Dante-B-777/FPV-2026/Report/figures/fig_alloc.pdf

1. slide the
collective
2. scale
roll+pitch
3. fit yaw in
what is left

umin
250 rad/s

hover
975 rad/s

umax
1600 rad/s

## rotor u = ω2

requested | roll/pitch spread

yaw

collective
