Dante-B-777/FPV-2026/Report/figures/fig_body.pdf

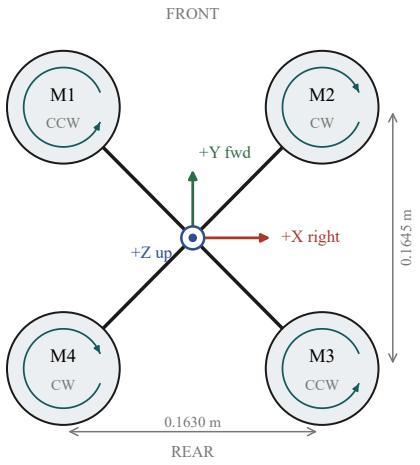
[picture p1: figure]
+X right; +Y fwd; FRONT; REAR; CCW

(a)
(b)
axis | M1 | M2 | M3 | M4 | produced by
Thrust T | | | | | kF Σui
Pitch τx | | | | | kFay(u1+u2−u3−u4)
Roll τy | | | | | kFax(u1−u2−u3+u4)
Yaw τz | | | | | −kM(u1−u2+u3−u4)

Filled = that rotor speeds up. ui = ω²
i

; ax = 0.0815 m, ay = 0.08225 m. A CCW rotor is driven against aerodynamic drag, so the airframe receives the opposite reaction. Yaw is therefore the only row set by kM instead of
kF, and kM/kF ≈ 0.01 m -- an eightfold authority deficit.

Sensor lever arms on the +Y centreline: PMW3901 at +0.040 m, VL53L0X at +0.070 m from the airframe centre.

+ | + | + | +
+ | + | − | −
+ | − | − | +
− | + | − | +
