Dante-B-777/FPV-2026/Report/figures/fig_states.pdf

(a) flight state machine

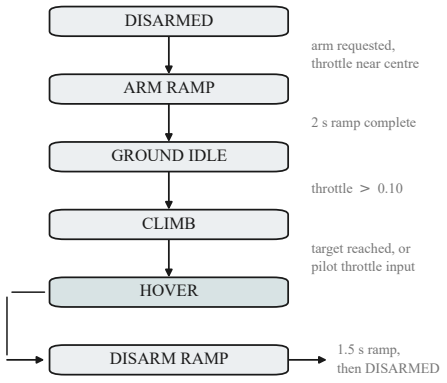
[picture p2: figure]
DISARMED; ARM RAMP; GROUND IDLE; CLIMB; HOVER; arm requested, throttle near centre; 2 s ramp complete; throttle > 0.10; target reached, or pilot throttle input; DISARM RAMP; 1.5 s ramp,; then DISARMED

released by: signal lost ⋅ kill ⋅ safety stop ⋅ serial stop ⋅ switch off

(b) per-axis hold engagement

stick input, or any precondition lost

capture requires the axis speed to stay below its threshold for the whole dwell, so the target is a point the vehicle is actually at:

altitude | 0.12 m/s | 400 ms
position | 0.15 m/s | 500 ms
heading | 8 deg/s | 300 ms

Position hold additionally requires proof, within this flight, that the yaw loop is behaving: rate within 10 deg/s and heading error within 8 deg, continuously for 3 s while airborne. Disarming clears the proof.
