Dante-B-777/FPV-2026/Report/preview/fig_alloc.png

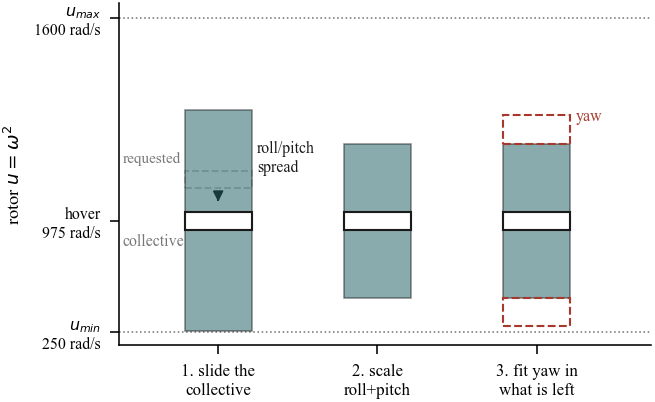
Report/preview/fig_alloc.png
