Dante-B-777/FPV-2026/Report/preview/fig_estimator.png

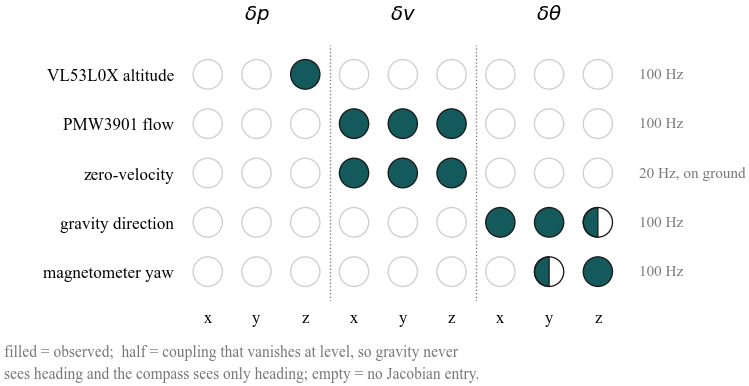
Report/preview/fig_estimator.png
