Dante-B-777/FPV-2026/Report/preview/fig_hover.png

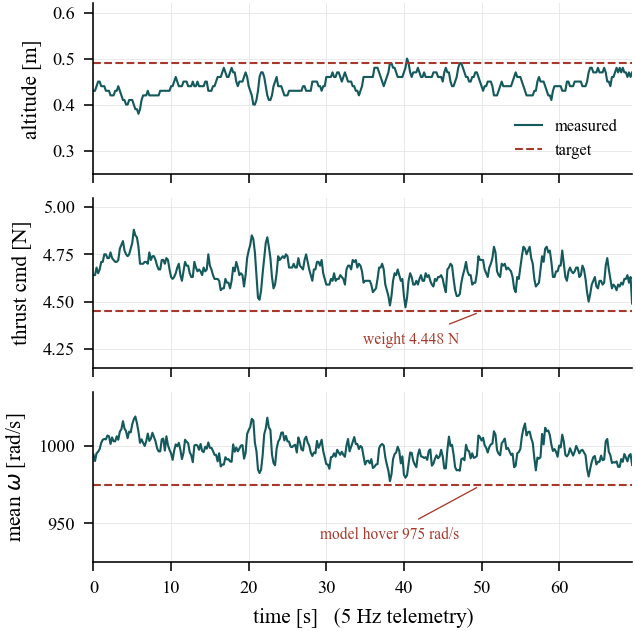
Report/preview/fig_hover.png
