Dante-B-777/FPV-2026/Schematics/wiring_transmitter.pdf

# FPV 2026 - TRANSMITTER

ESP32-WROOM-32 devkit | pins per Transmitter_RotorRate.ino | ESP-NOW peer 5C:01:3B:BA:CA:EC

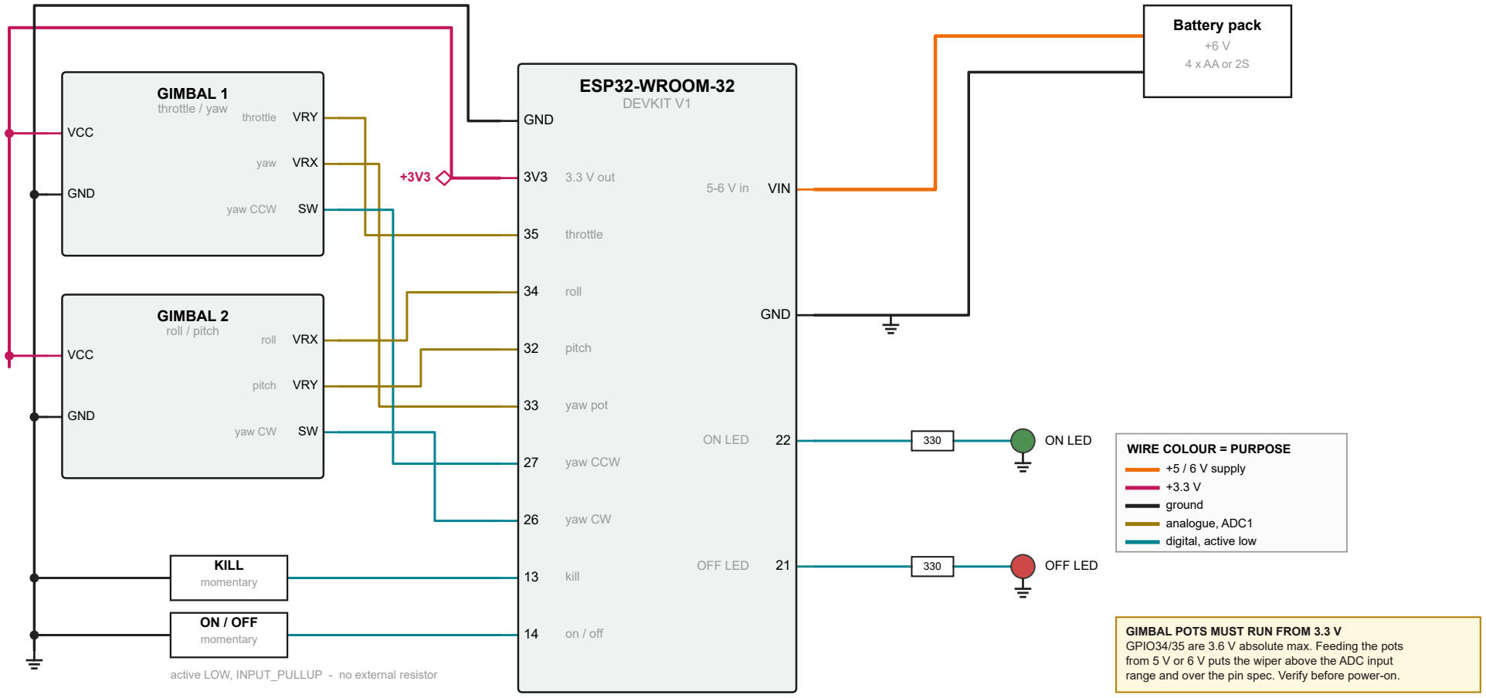
[picture p9: figure]
ESP32-WROOM-32 DEVKIT V1; GND; 3V3 3.3 V out; throttle; roll; pitch; yaw pot; yaw CCW; yaw CW; kill; on / off; VIN; ON LED; OFF LED; Battery pack; GIMBAL 1 throttle / yaw; VCC; VRY; yaw; VRX; GIMBAL 2 roll / pitch; KILL momentary; ON / OFF momentary; WIRE COLOUR = PURPOSE +5 / 6 V supply +3.3 V ground analogue, ADC1 digital, active low; GIMBAL POTS MUST RUN FROM 3.3 V

active LOW, INPUT_PULLUP - no external resistor

GPIO34/35 are 3.6 V absolute max. Feeding the pots from 5 V or 6 V puts the wiper above the ADC input range and over the pin spec. Verify before power-on.

NOTES
- All four axes use ADC1. ADC2 (0,2,4,12-15,25-27) cannot be read
while WiFi is up, and ESP-NOW keeps it up.
- GPIO33 yaw pot NOT FITTED: firmware default YAW_MODE 0 takes yaw from the two gimbal pushbuttons at +/-45 deg/s.
- GPIO34/35 are input-only; INPUT_PULLUP is unavailable there.
- Stick calibration lives in NVS, not in source.

SHEET

2 of 2 - transmitter

SOURCE

Transmitter_RotorRate.ino

LINK

ESP-NOW, 50 Hz
