Dante-B-777/FPV-2026/Schematics/wiring_transmitter.png

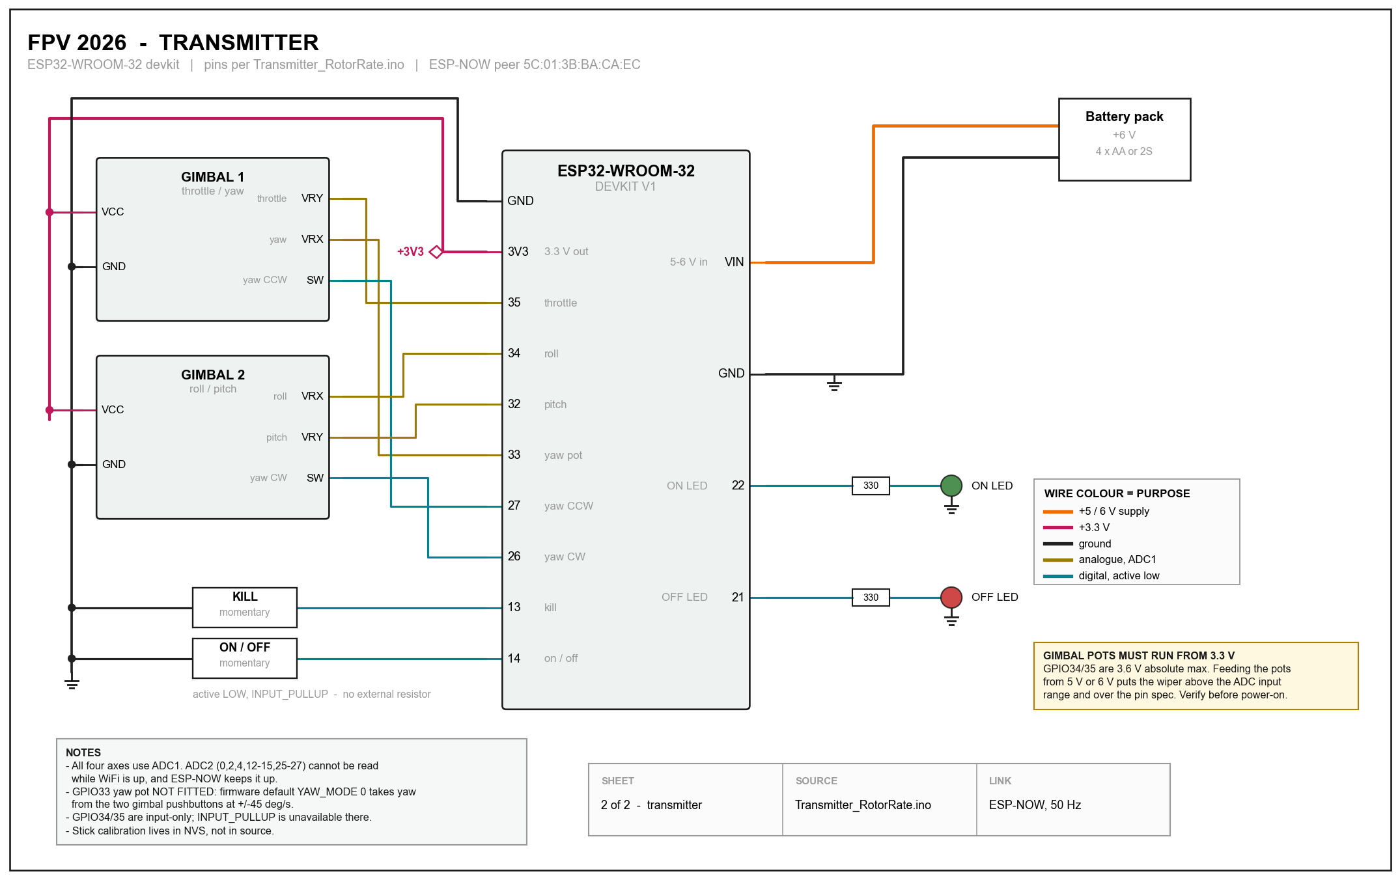
Schematics/wiring_transmitter.png
