Dante-B-777/FPV-2026/Schematics/wiring_receiver.pdf

# FPV 2026 - RECEIVER / FLIGHT CONTROLLER

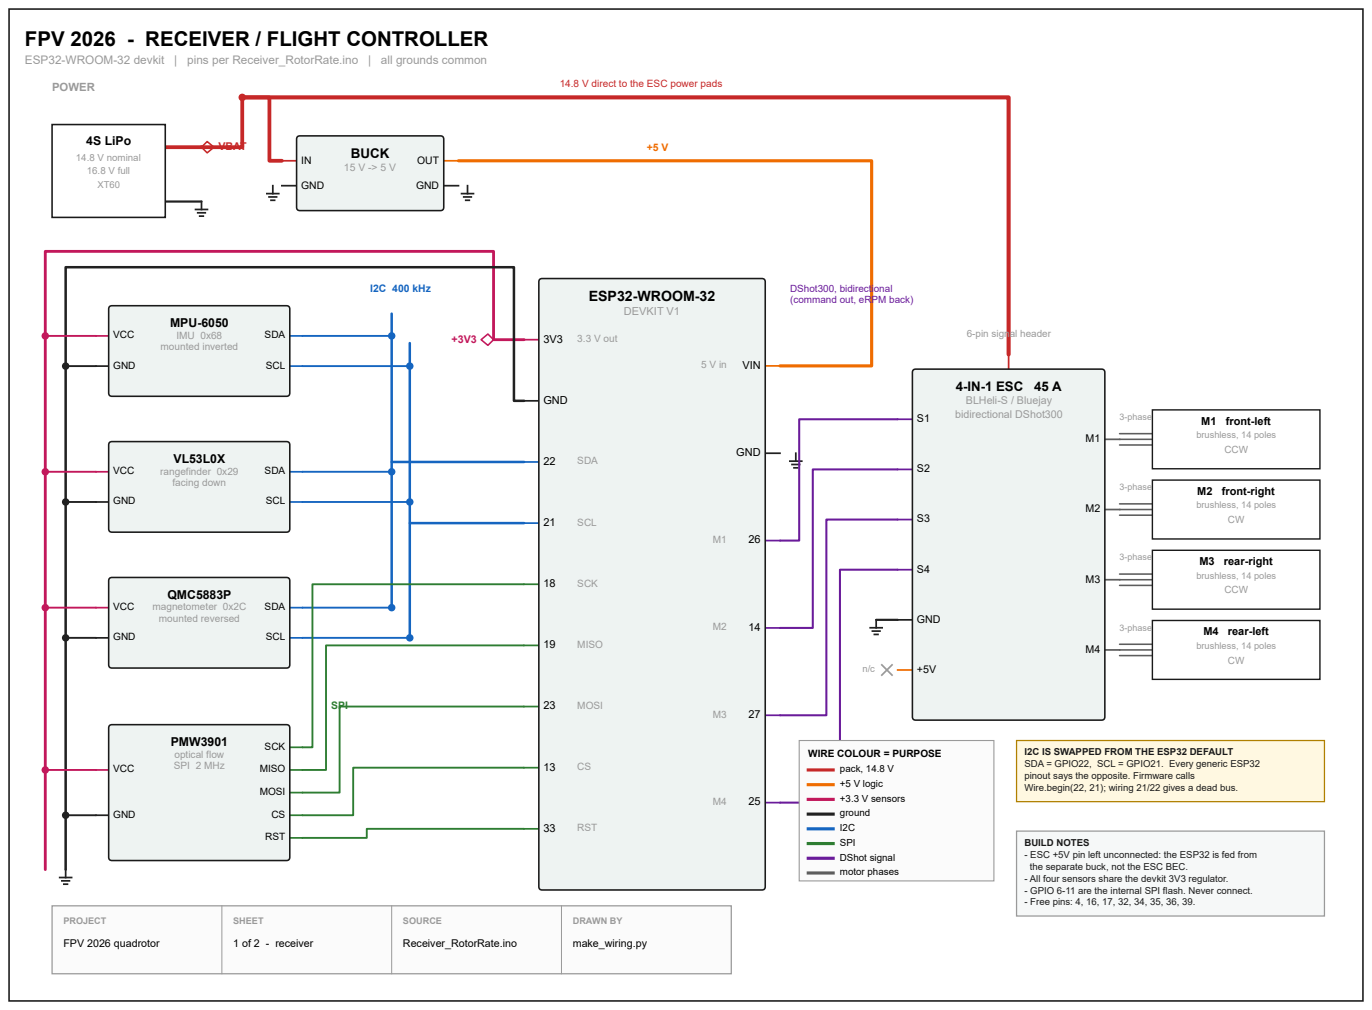
[picture p12: page 1]
POWER; I2C 400 kHz; SPI; 3-phase; 4S LiPo; 14.8 V nominal 16.8 V full XT60; VBAT; BUCK; GND; OUT; ESP32-WROOM-32 DEVKIT V1; 3V3 3.3 V out; SDA; SCL; SCK; MISO; MOSI; RST; VIN; MPU-6050 IMU 0x68 mounted inverted; VCC; VL53L0X rangefinder 0x29 facing down; QMC5883P magnetometer 0x2C mounted reversed; PMW3901 optical flow; 4-IN-1 ESC 45 A BLHeli-S / Bluejay bidirectional DShot300 S1; M1 front-left brushless, 14 poles CCW; M2 front-right brushless, 14 poles CW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

ESP32-WROOM-32 devkit | pins per Receiver_RotorRate.ino | all grounds common

14.8 V direct to the ESC power pads

DShot300, bidirectional
(command out, eRPM back)

6-pin signal header

I2C IS SWAPPED FROM THE ESP32 DEFAULT
SDA = GPIO22, SCL = GPIO21. Every generic ESP32
pinout says the opposite. Firmware calls
Wire.begin(22, 21); wiring 21/22 gives a dead bus.

SPI 2 MHz VCC

BUILD NOTES
- ESC +5V pin left unconnected: the ESP32 is fed from
the separate buck, not the ESC BEC.
- All four sensors share the devkit 3V3 regulator.
- GPIO 6-11 are the internal SPI flash. Never connect.
- Free pins: 4, 16, 17, 32, 34, 35, 36, 39.
