Dante-B-777/FPV-2026/Report/figures/fig_cascade.pdf

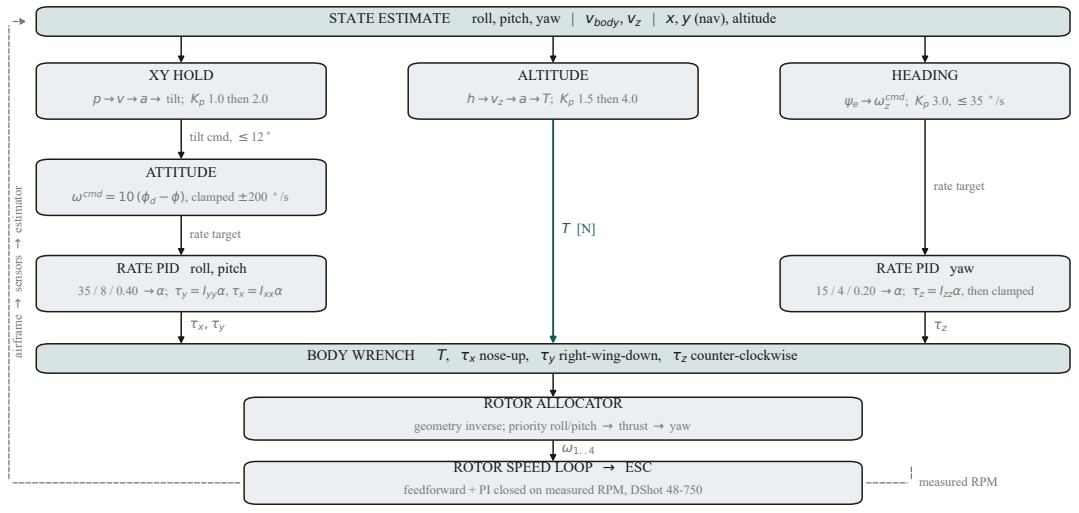
[picture p13: page 1]
STATE ESTIMATE; roll, pitch, yaw | vbody, vz | x, y (nav), altitude; XY HOLD; ALTITUDE; HEADING; ψe → ωcmd z; ATTITUDE; BODY WRENCH; T, τx nose-up, τy right-wing-down, τz counter-clockwise; ROTOR ALLOCATOR; feedforward + PI closed on measured RPM, DShot 48-750; measured RPM; tilt cmd, ≤ 12; rate target

p → v → a → tilt; Kp 1.0 then 2.0

h → vz → a → T; Kp 1.5 then 4.0

airframe → sensors → estimator

ωcmd = 10 (ϕd − ϕ), clamped ±200

RATE PID roll, pitch
35 / 8 / 0.40 → α; τy = Iyyα, τx = Ixxα

RATE PID yaw

15 / 4 / 0.20 → α; τz = Izzα, then clamped

geometry inverse; priority roll/pitch → thrust → yaw

ROTOR SPEED LOOP → ESC
