Dante-B-777/FPV-2026/Report/figures/fig_estimator.pdf

δp | δv | δθ

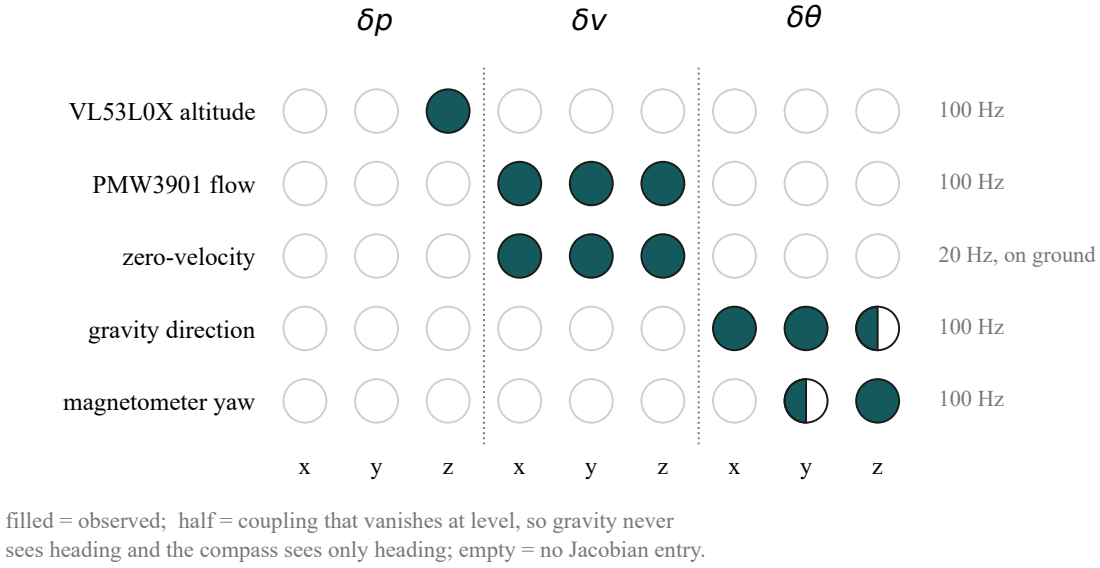
[picture p14: page 1]
VL53L0X altitude; PMW3901 flow; zero-velocity; gravity direction; magnetometer yaw

20 Hz, on ground

filled = observed; half = coupling that vanishes at level, so gravity never
sees heading and the compass sees only heading; empty = no Jacobian entry.
