Dante-B-777/FPV-2026/Report/figures/fig_hover.pdf

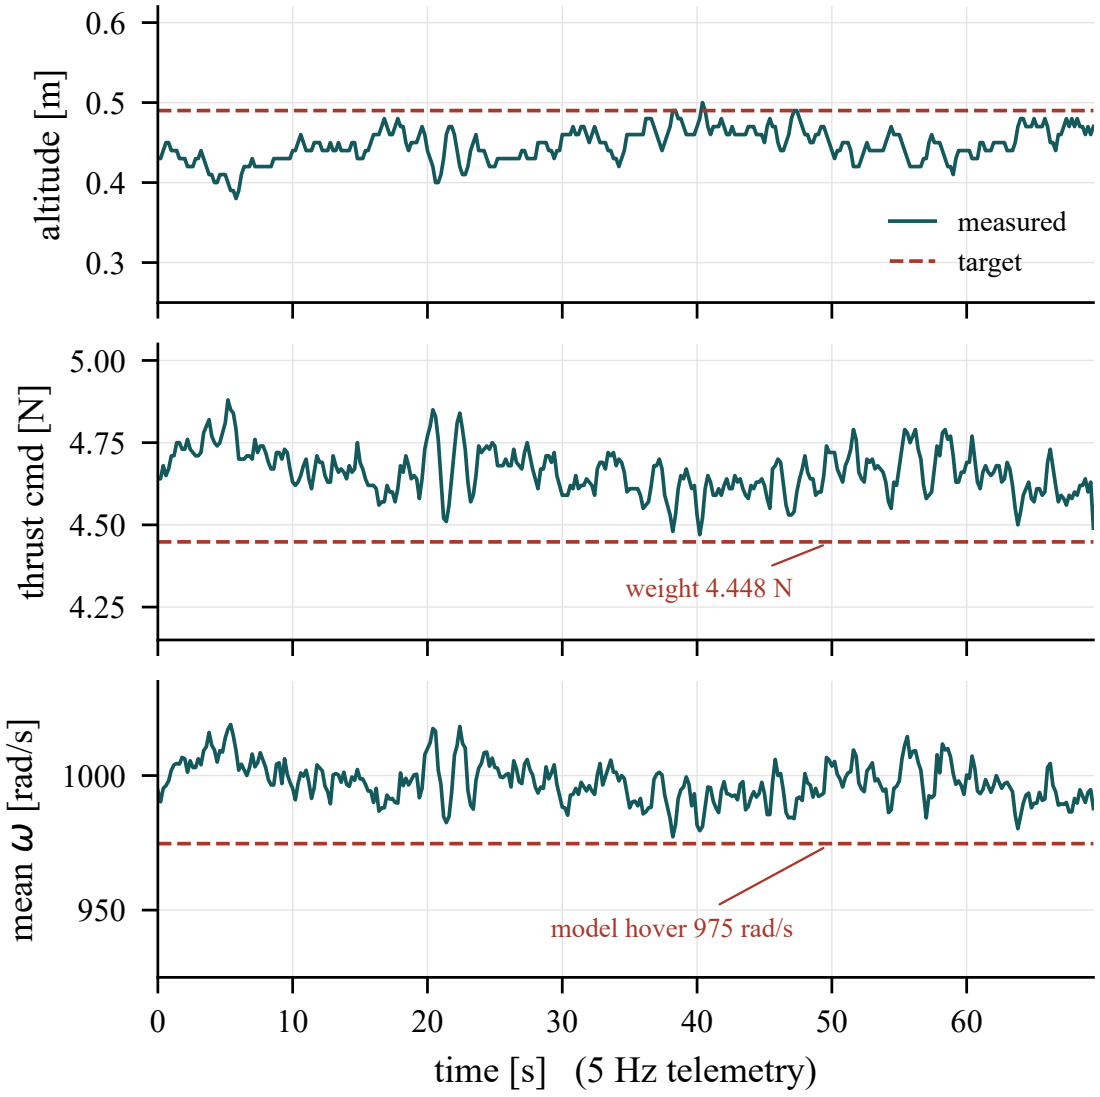
[picture p15: page 1]
altitude [m]; measured target; thrust cmd [N]; weight 4.448 N; mean ω [rad/s]

model hover 975 rad/s

time [s] (5 Hz telemetry)
