Dante-B-777/FPV-2026/Report/figures/fig_results.pdf

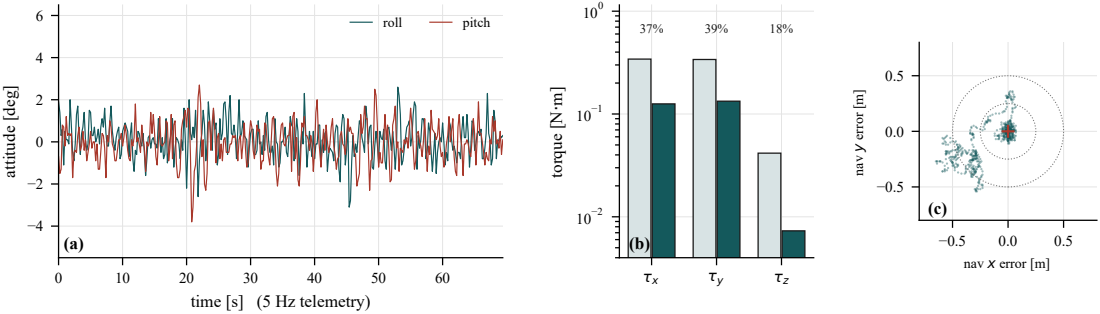
[picture p16: page 1]
attitude [deg]; roll; pitch; torque [N⋅m]; 0.5 nav x error [m]; nav y error [m]

time [s] (5 Hz telemetry)
