Dante-B-777/FPV-2026/Report/figures/fig_wiring.pdf

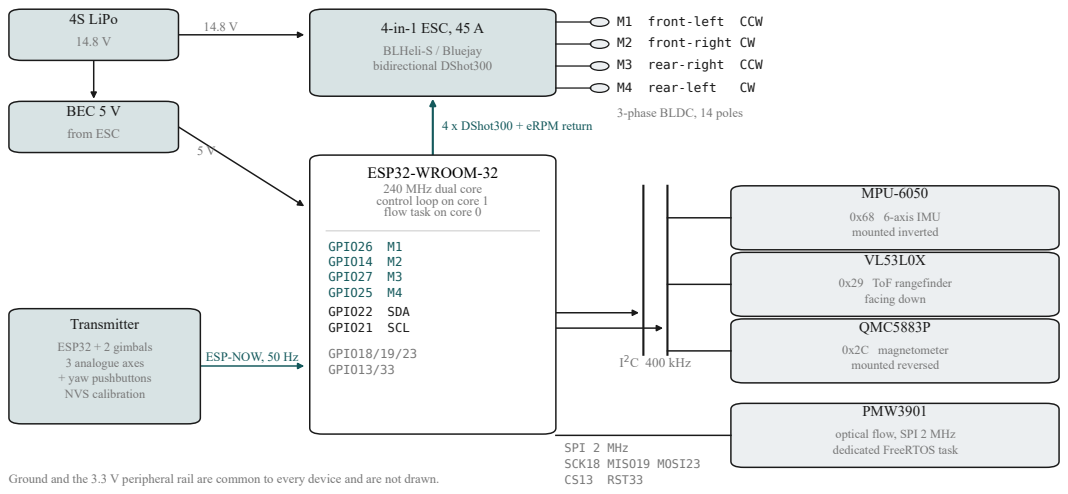
[picture p17: page 1]
4S LiPo; BEC 5 V; from ESC; 4-in-1 ESC, 45 A; BLHeli-S / Bluejay bidirectional DShot300; M1 front-left CCW; M4 rear-left; GPIO26 M1 GPIO14 M2 GPIO27 M3 GPIO25 M4 GPIO22 SDA GPIO21 SCL; GPIO18/19/23 GPIO13/33; 4 x DShot300 + eRPM return; 2C 400 kHz; MPU-6050; 0x68 6-axis IMU mounted inverted; 0x29 ToF rangefinder facing down; QMC5883P; 0x2C magnetometer mounted reversed; SPI 2 MHz; dedicated FreeRTOS task; SCK18 MISO19 MOSI23 CS13 RST33; Transmitter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

M2 front-right CW
M3 rear-right CCW
3-phase BLDC, 14 poles

ESP32-WROOM-32
240 MHz dual core
control loop on core 1
flow task on core 0

ESP-NOW, 50 Hz

PMW3901
optical flow, SPI 2 MHz

Ground and the 3.3 V peripheral rail are common to every device and are not drawn.
