Dante-B-777/FPV-2026/(list of files, drawings)

Other design files:
Schematics/FPVElectrical.ms14
