Dante-B-777/FPV-2026/(commit log)

2026-10-01 Initial commit: ESP32 rotor-rate quadrotor flight controller
    Flight firmware (receiver and transmitter), the 9-state error-state Kalman
    filter, derived rotor allocator, RPM-closed speed loop, in-flight yaw-torque
    identification, and the host-side validation suite. Plus sensor bring-up
    sketches, MATLAB rigid-body and LQR/NMPC simulations, generated wiring
    diagrams, flight logs, and the IEEEtran paper source.
    Vendor datasheets and reference papers are not redistributed.
2026-10-01 Correct airframe spec in README
    Frame separation and propeller radius now match FrameConventions.h
    (0.1630 m, R = 0.0635 m / 2.5 inch) and the paper, not the 5-inch figure.
2026-10-01 Correct airframe spec: 232 mm diagonal, 5-inch props
    PROP_RADIUS_M = 0.0635 is a 2.5-inch radius, i.e. a 5-inch propeller, and
    FRAME_SEPARATION_SIDE_SIDE_M = 0.1630 is the side-to-side spacing, which is
    232 mm across the diagonal.
2026-10-02 Fix validation suite path in README
    run_host_validation.sh lives in the ESKF packages; the Rotor_Rate package
    carries only the sign verifier.
